kopchik/semi_active_rectifier/semi-active-rectifier.asc

C1: cap; 10m
D1: schottky; RBR20T30A
D2: schottky; RBR20T30A
D3: schottky; RBR20T30A
D4: schottky; RBR20T30A
D5: zener; BZX84C8V2L
D6: zener; BZX84C8V2L
I1: current; 3
M1: nmos; Si4882DY
M2: nmos; Si4882DY
R2: res; 50k
R3: res; 50k
V1: voltage; SINE(0 15 50)
Named nets: 0
.tran 1
