kopchik/semi_active_rectifier/(list of files, drawings)

Other design files:
rectifier.dch
rectifier.dip
