kopchik/semi_active_rectifier/(commit log)

2020-09-10 pcb pic
2020-09-10 new file: schematic.png
2020-09-10 schematic in readme
2020-09-23 rectifier.dch: solder mask on link vias, trace width
    [rectifier.dch]
2020-09-23 rectifier.dip: bigger link vias hole
    [rectifier.dip]
